shapievabib-afk/Kalimba/photo_5447660613749383221_y.jpg

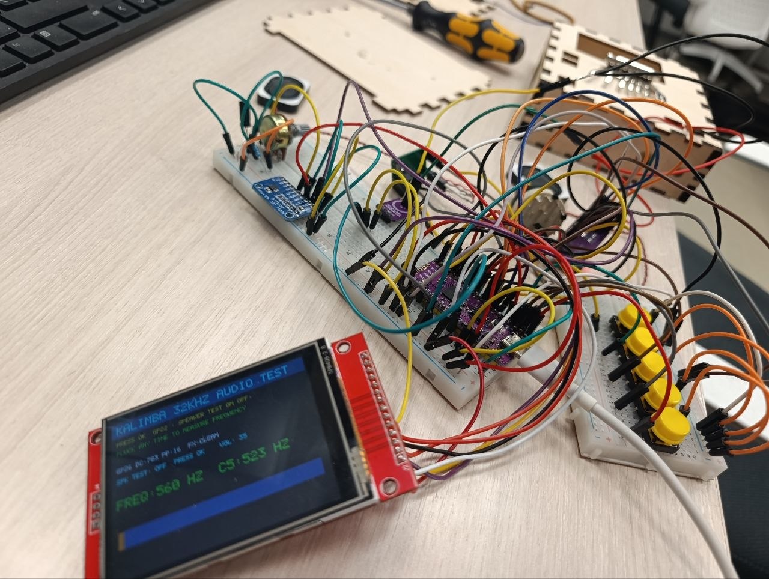
photo_5447660613749383221_y.jpg
