shapievabib-afk/Kalimba/info.txt

В данном репозитории будут коды, связанные с работой над микроконтроллером и софтом для падающих нот. позже информацию перенесу в ридми
