shapievabib-afk/Kalimba/Details/Сборка1.SLDASM

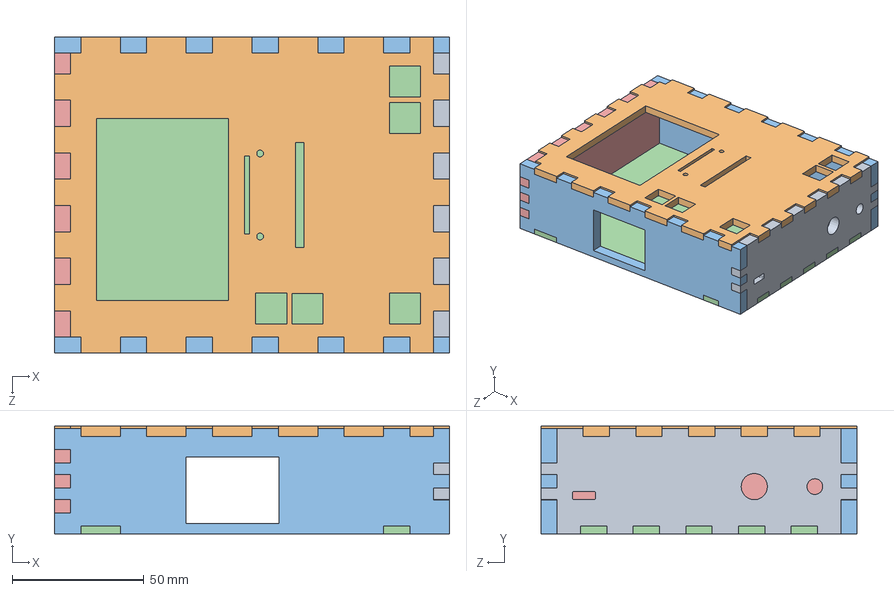
[picture p4: CAD file, 2026-10-31]
Details/Сборка1.SLDASM
150.0 x 41.0 x 120.0 mm
Верх_бок_дерево
ЗадняяКрышкаКалимбы
Левый_Бок_дерево x 2
ПередняяКрышкаКалимбы
днищеблять
