shapievabib-afk/Kalimba/Details/новые/днищеблять.SLDPRT

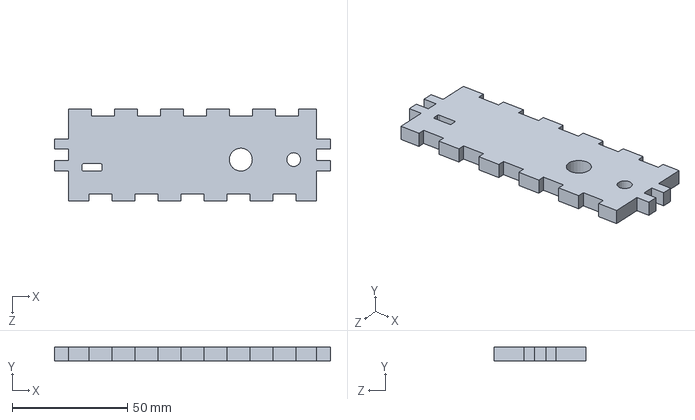
[picture p5: CAD file, 2026-11-10]
Details/новые/днищеблять.SLDPRT
120.0 x 6.00 x 40.0 mm
