shapievabib-afk/Kalimba/плата/PCB_Kalimba_final.dxf

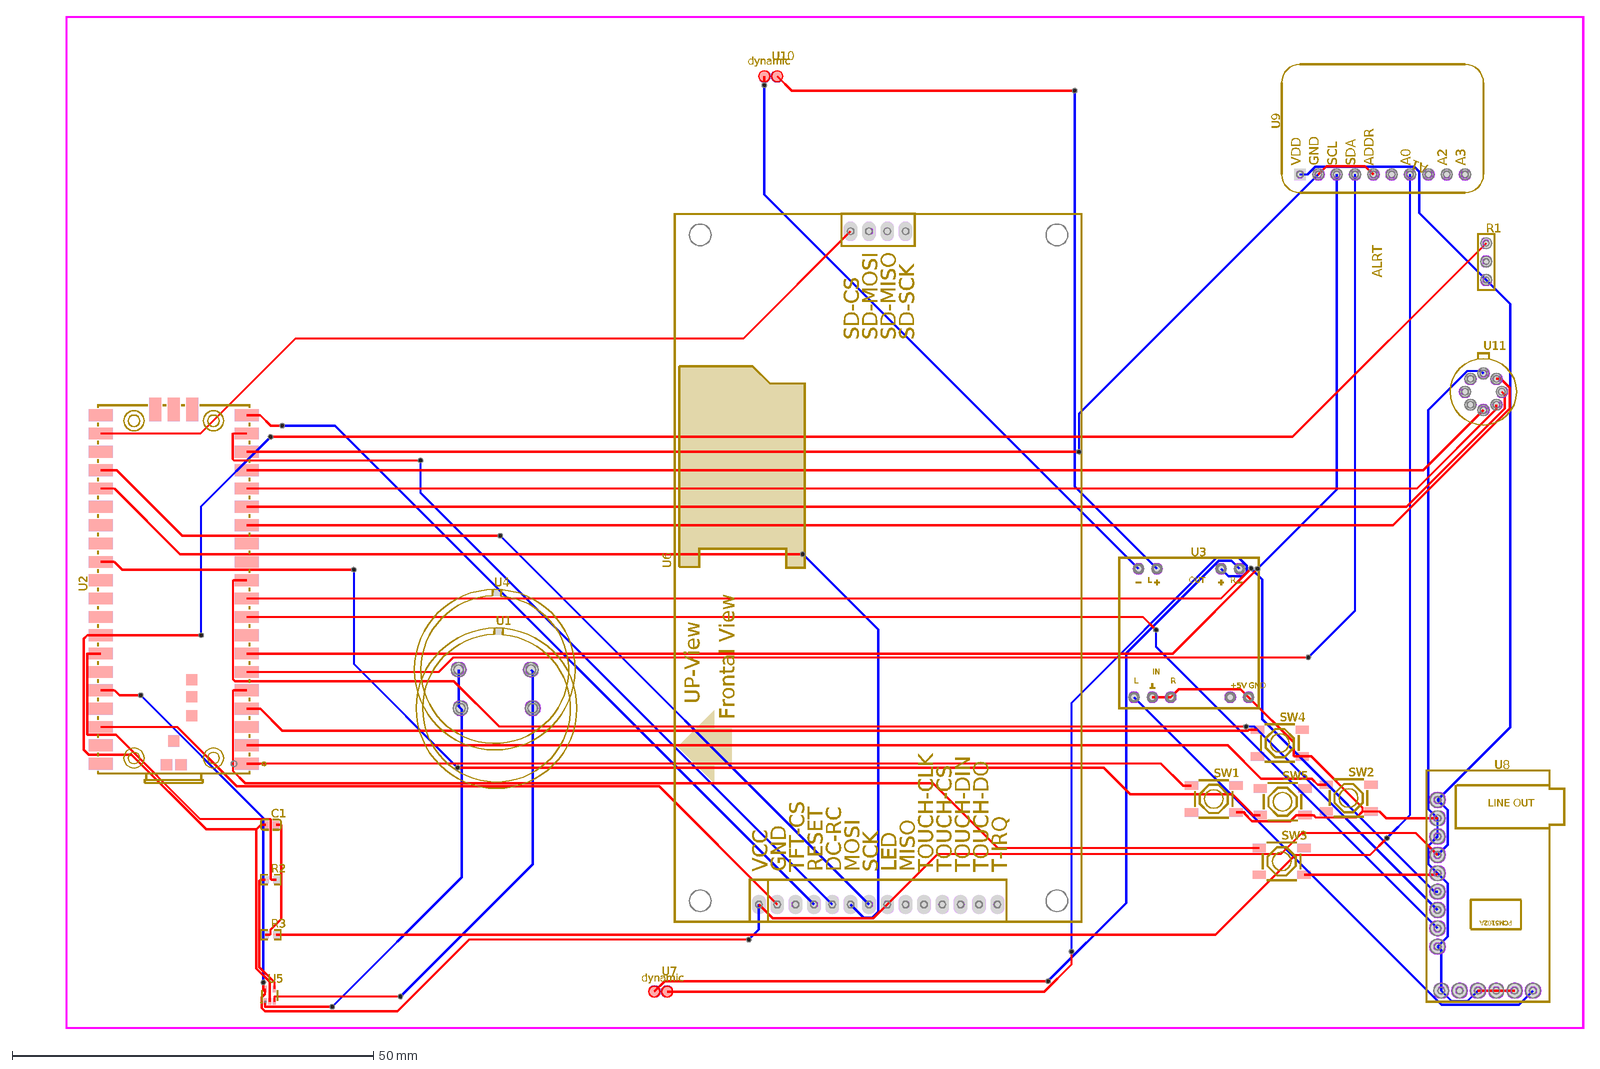
[picture p6: CAD file, 2026-11-10]
плата/PCB_Kalimba_final.dxf
C1
R1
R2
R3
SW1
SW2
SW3
SW4
SW5
U1
U4
U2
U3
IN
OUT
L
R
+5V
GND
U5
U6
VCC
RESET
TFT-CS
LED
SCK
MOSI
DC-RC
T-IRQ
TOUCH-DO
TOUCH-DIN
TOUCH-CS
TOUCH-CLK
MISO
SD-CS
SD-MOSI
SD-MISO
SD-SCK
UP-View
Frontal View
U7
dynamic
U10
U8
PCM5102A
LINE OUT
U9
VDD
SCL
SDA
ADDR
ALRT
A0
A1
A2
A3
U11
