shapievabib-afk/Kalimba/Details/новые/ПередняяКрышкаКалимбы.SLDPRT

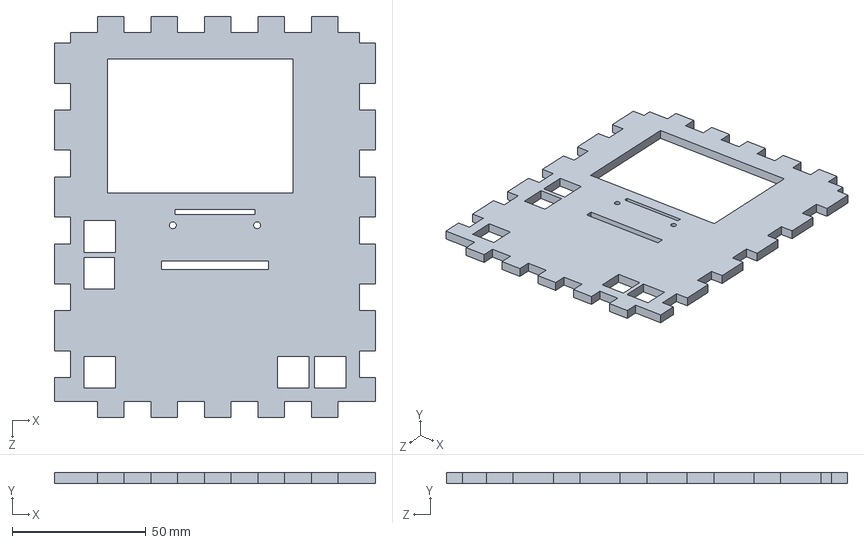
[picture p7: CAD file, 2026-11-10]
Details/новые/ПередняяКрышкаКалимбы.SLDPRT
120.0 x 4.00 x 150.0 mm
