shapievabib-afk/Kalimba/Details/новые/Левый_Бок_дерево.SLDPRT

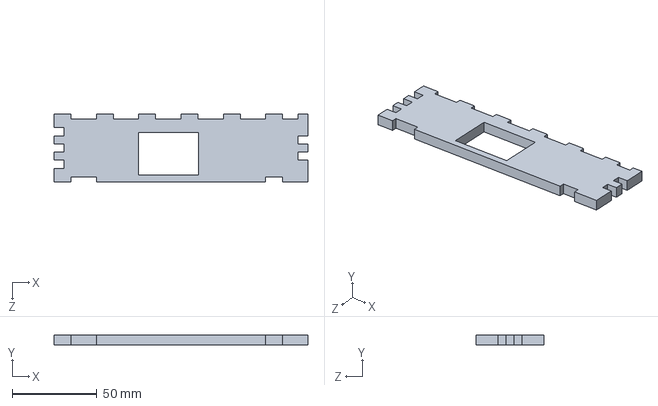
[picture p8: CAD file, 2026-11-10]
Details/новые/Левый_Бок_дерево.SLDPRT
150.0 x 6.00 x 40.0 mm
