shapievabib-afk/Kalimba/Details/новые/ЗадняяКрышкаКалимбы.SLDPRT

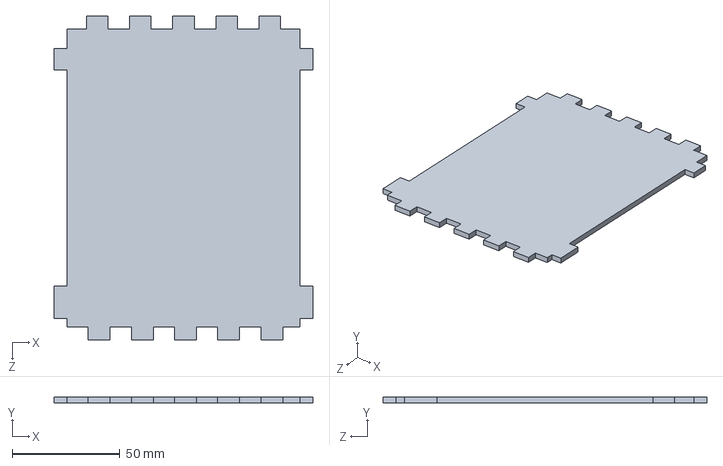
[picture p9: CAD file, 2026-11-10]
Details/новые/ЗадняяКрышкаКалимбы.SLDPRT
120.0 x 3.00 x 150.0 mm
