shapievabib-afk/Kalimba/Details/ПередняяКрышкаКалимбы.SLDPRT

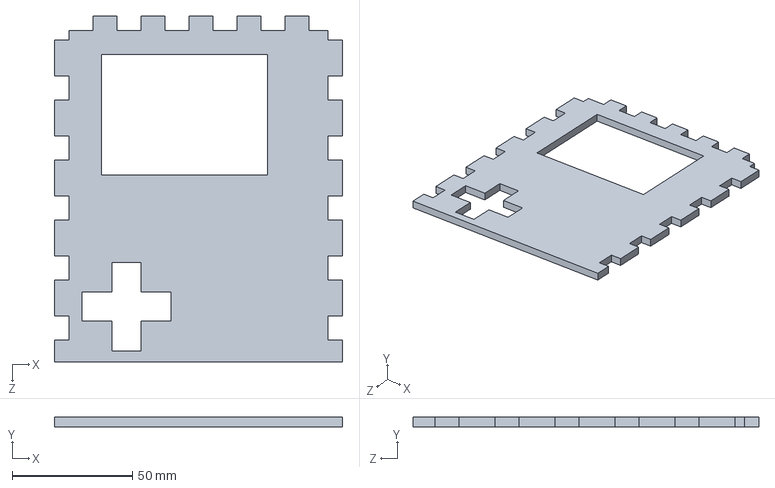
[picture p10: CAD file, 2026-10-31, an earlier design]
Details/ПередняяКрышкаКалимбы.SLDPRT
120.0 x 4.00 x 144.0 mm
