shapievabib-afk/Kalimba/Details/днищеблять.SLDPRT

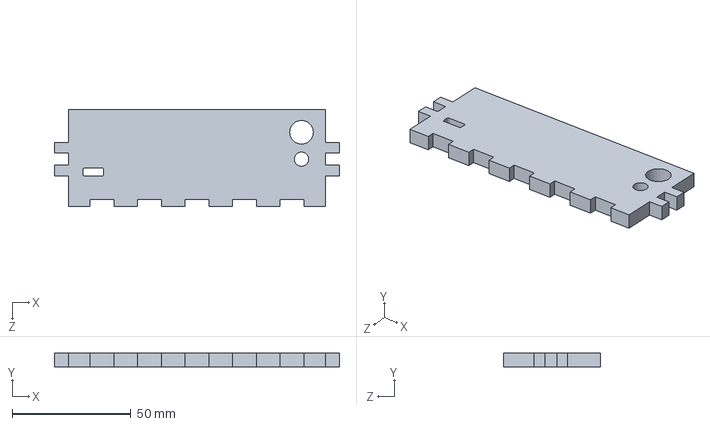
[picture p11: CAD file, 2026-10-31, an earlier design]
Details/днищеблять.SLDPRT
120.0 x 6.00 x 41.0 mm
