shapievabib-afk/Kalimba/(list of files, cad)

Other CAD files:
Details/новые/Верх_бок_дерево.SLDPRT
Details/ЗадняяКрышкаКалимбы.SLDPRT
Details/Левый_Бок_дерево.SLDPRT
