shapievabib-afk/Kalimba/codes/fixed_main/build/picotool/tmp/picotoolBuild-cfgcmd.txt

cmd='/usr/bin/cmake;--no-warn-unused-cli;-DCMAKE_MAKE_PROGRAM:FILEPATH=/usr/bin/ninja;-DPICO_SDK_PATH:FILEPATH=/home/zeverlanotebook/pico-sdk;-DPICOTOOL_NO_LIBUSB=1;-DPICOTOOL_FLAT_INSTALL=1;-DCMAKE_INSTALL_PREFIX=/home/zeverlanotebook/Repositories/Kalimba/codes/fixed_main/build/_deps;-DCMAKE_RULE_MESSAGES=OFF;-DCMAKE_INSTALL_MESSAGE=NEVER;-GNinja;-S;<SOURCE_DIR><SOURCE_SUBDIR>;-B;<BINARY_DIR>'
