shapievabib-afk/Kalimba/codes/прошивка/build/_deps/picotool-build/install_manifest.txt

/home/zeverlanotebook/Repositories/Kalimba/codes/прошивка/build/_deps/picotool/picotool
/home/zeverlanotebook/Repositories/Kalimba/codes/прошивка/build/_deps/picotool/picotoolTargets.cmake
/home/zeverlanotebook/Repositories/Kalimba/codes/прошивка/build/_deps/picotool/picotoolTargets-release.cmake
/home/zeverlanotebook/Repositories/Kalimba/codes/прошивка/build/_deps/picotool/picotoolConfig.cmake
/home/zeverlanotebook/Repositories/Kalimba/codes/прошивка/build/_deps/picotool/picotoolConfigVersion.cmake
/home/zeverlanotebook/Repositories/Kalimba/codes/прошивка/build/_deps/picotool/enc_bootloader.elf
/home/zeverlanotebook/Repositories/Kalimba/codes/прошивка/build/_deps/picotool/enc_bootloader_mbedtls.elf
