shapievabib-afk/Kalimba/codes/прошивка/build/_deps/picotool-subbuild/picotool-populate-prefix/src/picotool-populate-stamp/picotool-populate-update-info.txt

# This is a generated file and its contents are an internal implementation detail.
# The patch step will be re-executed if anything in this file changes.
# No other meaning or use of this file is supported.

command (connected)=/usr/bin/cmake;-Dcan_fetch=YES;-P;/home/zeverlanotebook/Repositories/Kalimba/codes/прошивка/build/_deps/picotool-subbuild/picotool-populate-prefix/tmp/picotool-populate-gitupdate.cmake
command (disconnected)=/usr/bin/cmake;-Dcan_fetch=NO;-P;/home/zeverlanotebook/Repositories/Kalimba/codes/прошивка/build/_deps/picotool-subbuild/picotool-populate-prefix/tmp/picotool-populate-gitupdate.cmake
work_dir=/home/zeverlanotebook/Repositories/Kalimba/codes/прошивка/build/_deps/picotool-src
