shapievabib-afk/Kalimba/codes/прошивка/build/pico-sdk/src/rp2_common/pico_cyw43_driver/pioasm/tmp/pioasmBuild-cfgcmd.txt

cmd='/usr/bin/cmake;--no-warn-unused-cli;-DCMAKE_MAKE_PROGRAM:FILEPATH=/usr/bin/ninja;-DPIOASM_FLAT_INSTALL=1;-DCMAKE_INSTALL_PREFIX=/home/zeverlanotebook/Repositories/Kalimba/codes/прошивка/build/pioasm-install;-DCMAKE_RULE_MESSAGES=OFF;-DCMAKE_INSTALL_MESSAGE=NEVER;-GNinja;-C<TMP_DIR>/pioasmBuild-cache-$<CONFIG>.cmake;-S;<SOURCE_DIR><SOURCE_SUBDIR>;-B;<BINARY_DIR>'
