shapievabib-afk/Kalimba/плата/PCB_PCB_Kalimba_2_2026-11-09.pdf

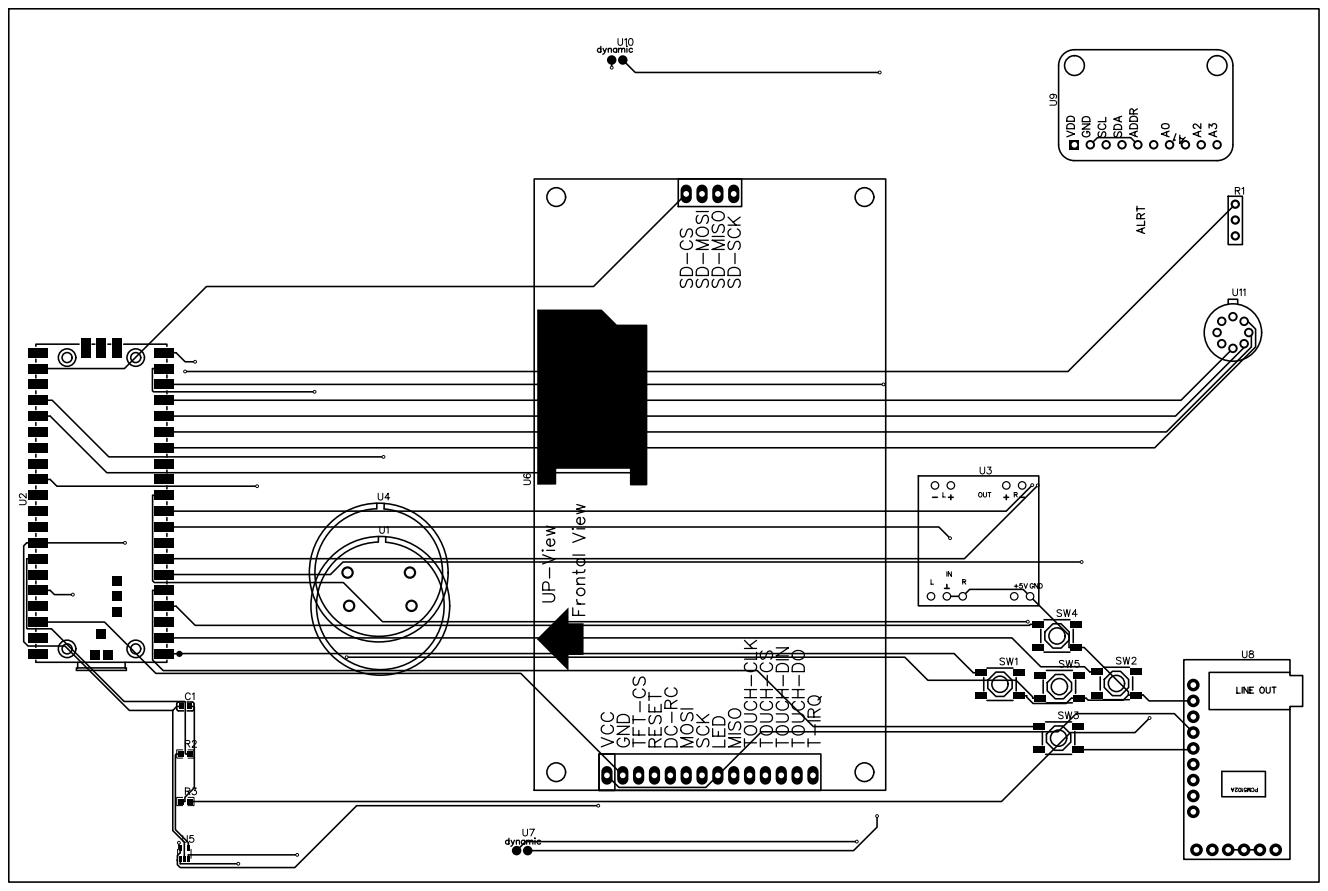
[picture p12: page 1]
