shapievabib-afk/Kalimba/(list of files, drawings)

Other design files:
плата/PCB_PCB_Kalimba_FinalEDA.json
