shapievabib-afk/Kalimba/(commit log)

2026-09-25 Начало положено!
2026-10-31 Details are added
    [Верх_бок_дерево.SLDPRT, ЗадняяКрышкаКалимбы.SLDPRT, Левый_Бок_дерево.SLDPRT, ПередняяКрышкаКалимбы.SLDPRT, Сборка1.SLDASM, днищеблять.SLDPRT]
2026-11-05 Первый тестовый код
2026-11-10 Завезли детали с платой
    [PCB_Kalimba_final.dxf, PCB_PCB_Kalimba_FinalEDA.json, Верх_бок_дерево.SLDPRT, ЗадняяКрышкаКалимбы.SLDPRT, Левый_Бок_дерево.SLDPRT, ПередняяКрышкаКалимбы.SLDPRT, днищеблять.SLDPRT]
